drgerg/ohd/Docs/ohd Hardware Unit-flt.pdf

# 12V 7ah gel cell

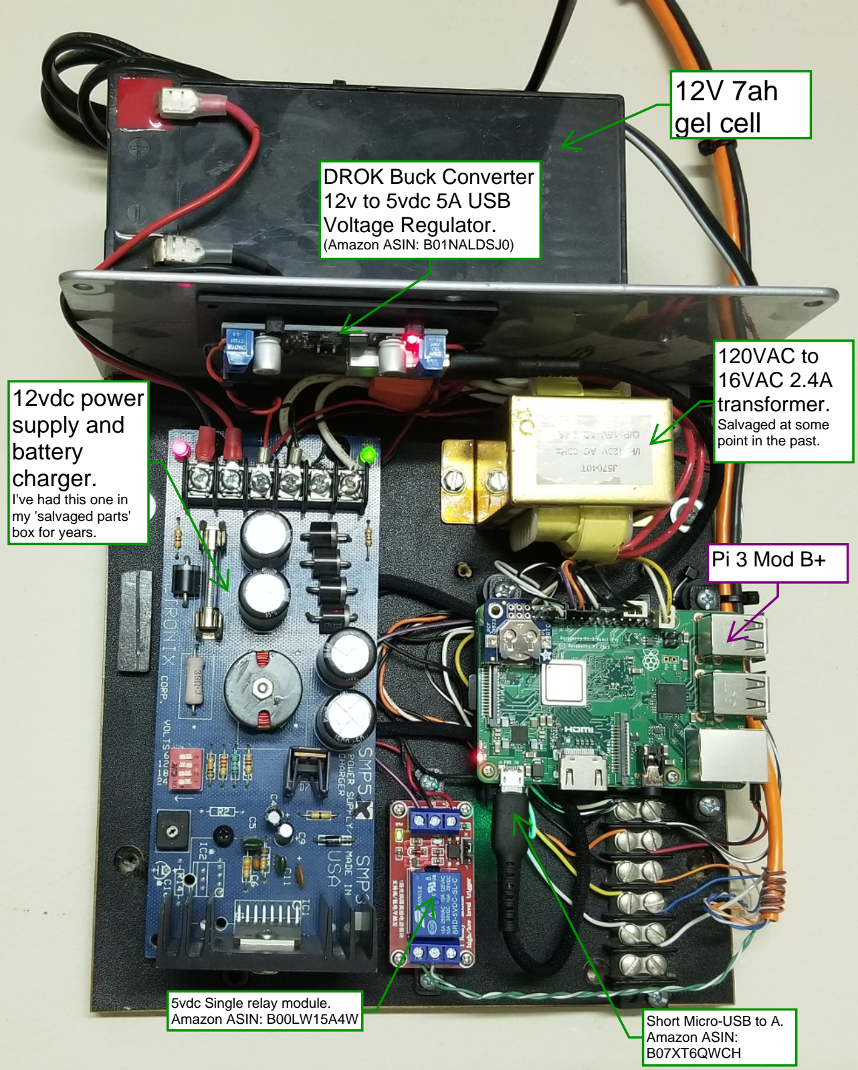
[picture p1: page 1]

## 12vdc power supply and battery

charger.
I've had this one in
my 'salvaged parts'
box for years.

## 120VAC to 16VAC 2.4A

transformer.
Salvaged at some
point in the past.

## DROK Buck Converter 12v to 5vdc 5A USB

Voltage Regulator.
(Amazon ASIN: B01NALDSJ0)

Short Micro-USB to A.
Amazon ASIN:
B07XT6QWCH

## Pi 3 Mod B+

5vdc Single relay module.
Amazon ASIN: B00LW15A4W
