drgerg/ohd/Docs/Bypass Button-flt.pdf

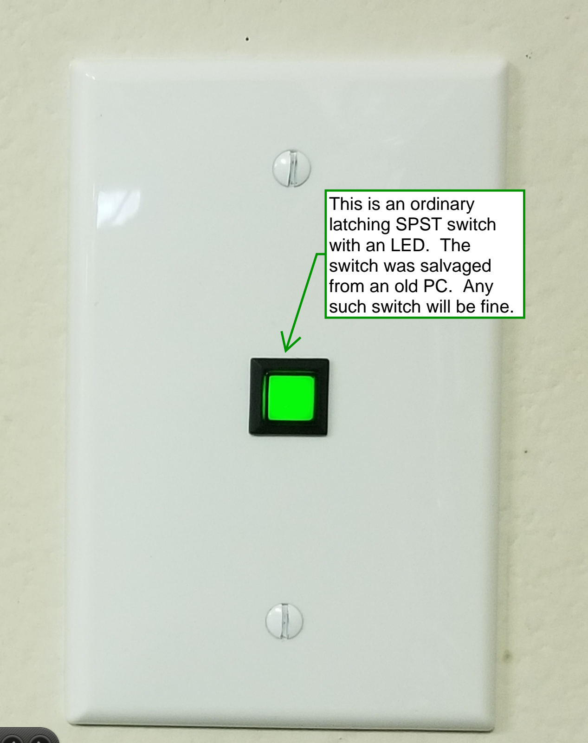
[picture p2: page 1]

This is an ordinary
latching SPST switch
with an LED. The
switch was salvaged
from an old PC. Any
such switch will be fine.
