drgerg/ohd/(list of files, cad)

Other CAD files:
Docs/GarageDoorMonitorRPi2020.dwg
SupportingFiles/GarageDoorMonitorRPi2020.dwg
Docs/RASPBERRY_PI_40-PIN_HEADER.dwg
SupportingFiles/RASPBERRY_PI_40-PIN_HEADER.dwg
