drgerg/ohd/Docs/RASPBERRY_PI_40-PIN_HEADER-Paper.pdf

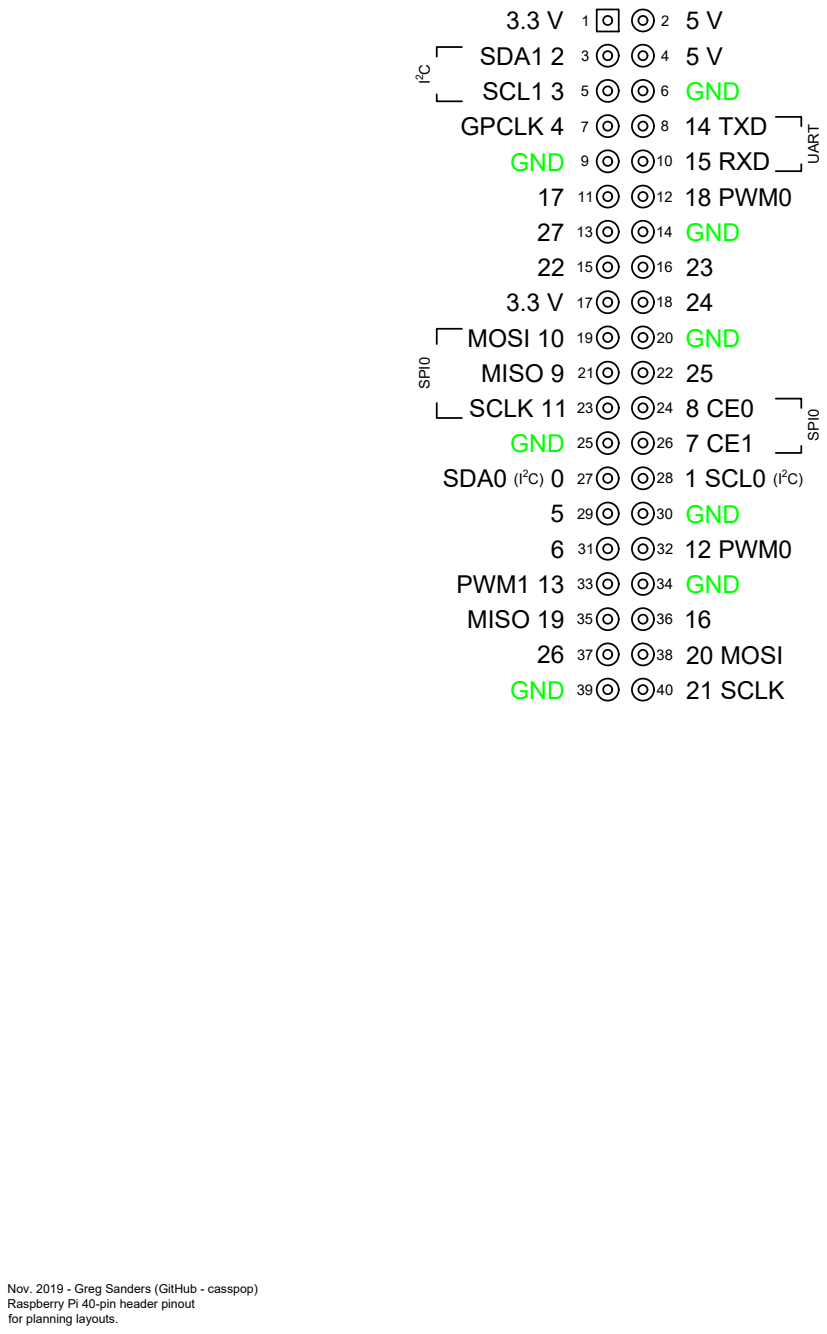
[picture p3: page 1]
3.3 V SDA1 2 SCL1 3 GPCLK 4 GND172722 3.3 V MOSI 10 MISO 9 SCLK 11 GND SDA0 (I2C) 056 PWM1 13 MISO 1926 GND; 5 V 5 V GND 14 TXD 15 RXD 18 PWM0 GND 2324GND 258 CE0 7 CE1 1 SCL0 (I2C) GND 12 PWM0 GND 1620 MOSI 21 SCLK; UART 13579111315171921232527293133353739 246810121416182022242628303234363840

SPI0 I2C Nov. 2019 - Greg Sanders (GitHub - casspop)

Raspberry Pi 40-pin header pinout
for planning layouts.
