drgerg/ohd/Docs/GarageDoorMonitorRPi2020.pdf

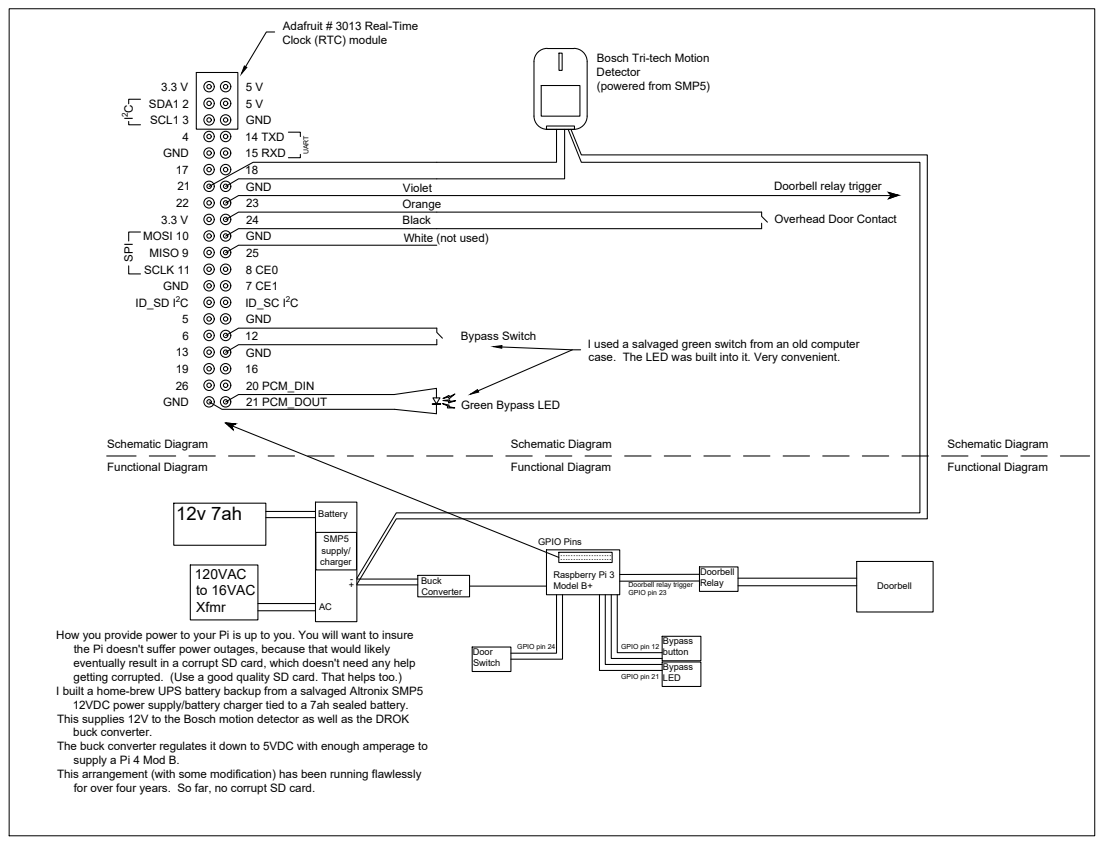
[picture p4: page 1]
3.3 V SDA1 2 SCL1 34 GND172122 3.3 V MOSI 10 MISO 9 SCLK 11 GND ID_SD I2C56131926 GND; 5 V 5 V GND 14 TXD 15 RXD 18GND 2324GND 258 CE0 7 CE1 ID_SC I2C GND 12GND 1620 PCM_DIN 21 PCM_DOUT; SPI I2C; Orange Black; I used a salvaged green switch from an old computer; for over four years. So far, no corrupt SD card.; Bosch Tri-tech Motion Detector (powered from SMP5) Adafruit # 3013 Real-Time Clock (RTC) module; White (not used) Violet 12v 7ah; SMP5 supply/ charger 120VAC to 16VAC Xfmr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

UART Overhead Door Contact Bypass Switch

case. The LED was built into it. Very convenient.

Green Bypass LED

How you provide power to your Pi is up to you. You will want to insure
the Pi doesn't suffer power outages, because that would likely
eventually result in a corrupt SD card, which doesn't need any help
getting corrupted. (Use a good quality SD card. That helps too.)
I built a home-brew UPS battery backup from a salvaged Altronix SMP5
12VDC power supply/battery charger tied to a 7ah sealed battery.
This supplies 12V to the Bosch motion detector as well as the DROK buck converter. The buck converter regulates it down to 5VDC with enough amperage to

supply a Pi 4 Mod B.
This arrangement (with some modification) has been running flawlessly
