drgerg/ohd/v2.x.x_code/ohdsendmail.py

#!/usr/bin/env python3

""" ohdsendmail.py - (OverHead Door) Email pre-configured messages.
    2019 - Gregory Allen Sanders"""

import os
import socket
import sys
import configparser
import logging
import time
import signal
import ohdpinchk
import pickle
#
## ConfigParser init area.  Get some info out of working.conf.
#
ohdHome = os.getcwd()
config = configparser.RawConfigParser()
config.read(ohdHome + '/ohd.conf')
#
## End ConfigParser init

logger = logging.getLogger(__name__)

logger.debug("Sending Message")


def main(bpStatv):
    logger.debug("Started the main() function")
    doorStat = ohdpinchk.pinChk()
    bpStat = ohdpinchk.bpChk(bpStatv)
    tMsg = "The door is " + doorStat + " and ByPass is " + bpStat
    tSub = "Door Status Change"
    ## send status to the RemPi's everywhere.
    ohdStat("192.168.1.17",64444,doorStat,bpStat)
    ohdStat("192.168.1.16",64444,doorStat,bpStat)
    ohdStat("192.168.1.18",64444,doorStat,bpStat)
    ohdStat("192.168.1.27",64444,doorStat,bpStat)
    msgS(tSub, tMsg)
    logger.debug("Finished the Main() function")


def msgS(tSub, tMsg):
    logger.debug("Started msgS() function")
    x = int(config.get('Notify', 'NotifyNumber'))
    tNow = time.strftime("%H:%M:%S", time.localtime())
    for i in range(1, x+1):
        Email = config.get('Notify', 'NotifyEmail' + str(i))
        os.system("echo " + tMsg + " at " + tNow + " | mail -s " + "\'" + tSub + "\' " + Email)
    logger.info("'" + tMsg + "' Message Sent")
    logger.debug("Finished the msgS() function")

def ohdStat(address,port,doorStat,bpStat):
    addr = address
    port = port
    ohdStatData = doorStat,bpStat
    # print("From socketClient.py: " + str(ohdStatData))
    try:
        with socket.socket(socket.AF_INET, socket.SOCK_STREAM) as ps:
            ps.connect((addr, port))
            banner = ps.recv(2048)
            introBanner = banner.decode()
            # print(introBanner)
            ## Send 'wxIncoming' to get the other end ready.
            sockReq = pickle.dumps("ohdIncoming")
            ps.sendall(sockReq)
            time.sleep(0.5)
            ## Send the new data.
            sockReq = pickle.dumps(ohdStatData)
            ps.sendall(sockReq)
            ps.close()
            # print("sent and closed")
    ## Unless there's a problem.
    except socket.error as err:
        print("While trying to reach " + str(addr) + ",")
        print("ohdsendmail ohdStat() function experienced an error:" + str(err))
        # logger.info('There was an error: ' + str(err))
        # sys.exit(1)
        pass

def SignalHandler(signal, frame):
        logger.info("Cleaning up . . . \n = = = = = = = = = = = = = = = = = = = = = = = = = = = = = = = =")
        logger.info("Shutting down gracefully")
        logger.debug("This is SignalHandler")
        logger.info("Displayed .info and .debug in SignalHandler")
        logger.info("Shutdown initiated")
        logger.debug("Wrote to log in SignalHandler")
        sys.exit(0)


if __name__ == "__main__":
        try:
            import argparse

            ## Command line arguments parsing
            #
            parsersm = argparse.ArgumentParser()
            parsersm.add_argument("-d", "--debug", help="Turn on debugging output to stderr", action="store_true")
            argssm = parsersm.parse_args()
            if argssm.debug:
                logging.basicConfig(filename=ohdHome + '/ohd.log', format='[%(name)s]:%(levelname)s: %(message)s. - %(asctime)s', datefmt='%D %H:%M:%S', level=logging.DEBUG)
                logging.info("Debugging output enabled")
            else:
                logging.basicConfig(filename=ohdHome + '/ohd.log', format='%(asctime)s - %(message)s in %(name)s.', datefmt='%a, %d %b %Y %H:%M:%S', level=logging.INFO)
            #
            ## End Command line arguments parsing

            signal.signal(signal.SIGINT, SignalHandler)
            logger.debug("Top of try")
            main("On")
            logger.info("Bottom of try")

        except:
            pass
            logger.info("That's all folks.  Goodbye")
