drgerg/ohd/(commit log)

2019-11-10 Raspberry Pi header Pinout pdf .dwg
    [RASPBERRY_PI_40-PIN_HEADER.dwg]
2019-11-12 Minor Correction to GPIO diagram
    [RASPBERRY_PI_40-PIN_HEADER.dwg]
2019-11-24 Updates for Buster
    Changes including the addition of support for a PIR Motion detector on pin 18.
2019-12-02 threaded PIR checking
    Put PIR checking in a threading.Timer() thread, and added the condition that the Bypass button not be pressed for PIR notifications.
2020-07-04 2020 updates beginning
    [GarageDoorMonitorRPi2020.dwg]
2020-07-04 Create Bypass Button-flt.pdf
2020-07-05 2020 Updates
    [GarageDoorMonitorRPi2020.dwg]
2023-01-22 Jan_2023 updates
    [GarageDoorMonitorRPi2020.dwg, RASPBERRY_PI_40-PIN_HEADER.dwg]
2023-06-04 v2.2.0 update
    Added camera recording when OHD is opened.
    [GarageDoorMonitorRPi2020.dwg, RASPBERRY_PI_40-PIN_HEADER.dwg]
2023-06-04 v2.2.0 update
    Added camera recording when OHD opened. Also cleaned out the old 'ohd' folder in this repository.
